Srcodesalittle/Ignition-panel-to-wake-on-lan/Circtuit diagram.PNG

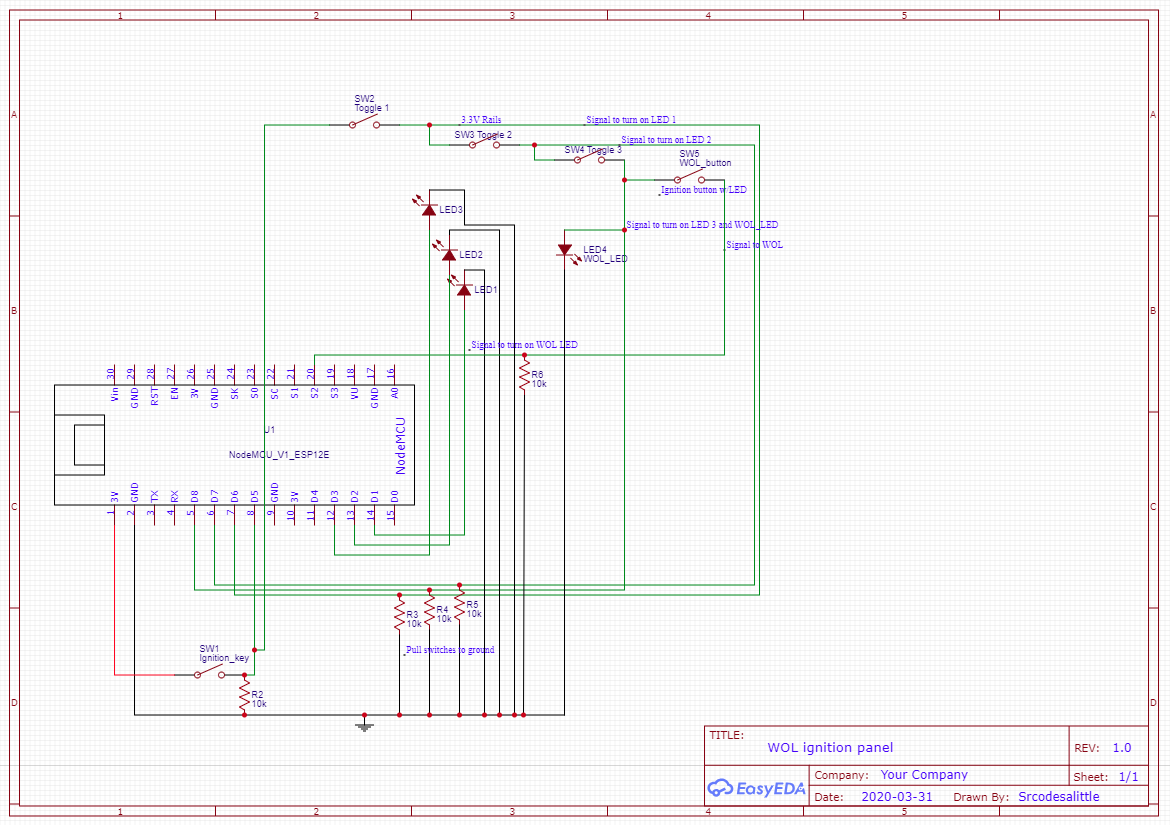
Circtuit diagram.PNG
