Srcodesalittle/Ignition-panel-to-wake-on-lan/Ign_1.jpg

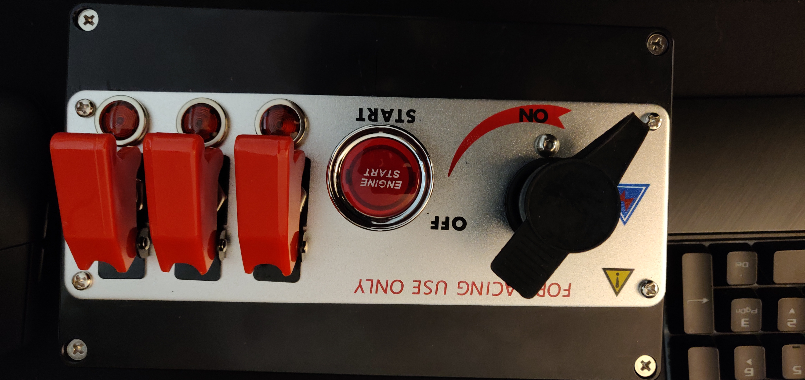
Ign_1.jpg
