Srcodesalittle/Ignition-panel-to-wake-on-lan/Ign_2.jpg

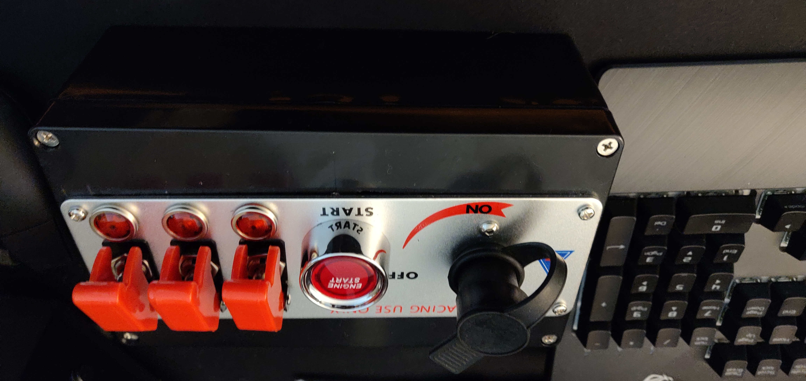
Ign_2.jpg
