Srcodesalittle/Ignition-panel-to-wake-on-lan/Ign_3.jpg

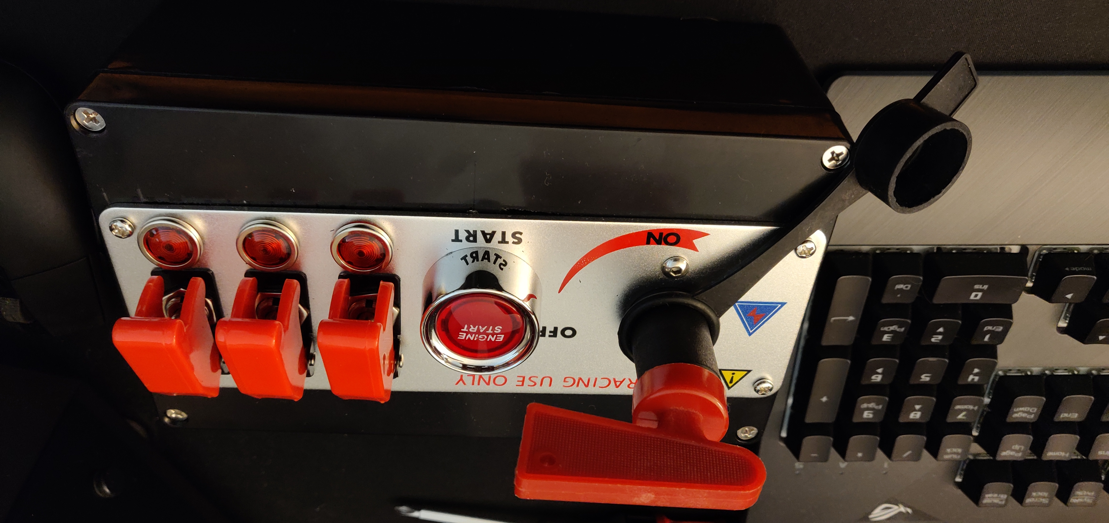
Ign_3.jpg
