Srcodesalittle/Ignition-panel-to-wake-on-lan/Final bill of materials.xlsx

Item | url | price (USD)
Ignition panel | https://www.aliexpress.com/item/32843875349.html?pid=808_0000_0231 | 14.64
nodemcu esp8266 | https://www.amazon.com/HiLetgo-Internet-Development-Wireless-Micropython/dp/B081CSJV2V/ | 13.99
resistors | https://www.amazon.com/AUSTOR-Resistors-Assortment-Resistor-Experiments/dp/B07BKRS4QZ | 10.59
jumper wires | https://www.amazon.com/Solderless-Flexible-Breadboard-Jumper-100pcs/dp/B005TZJ0AM | 7.29
breadboard ** | https://www.amazon.com/DEYUE-breadboard-Set-Prototype-Board/dp/B07LFD4LT6 | 8.99
soddering bread board** | https://www.amazon.com/Cylewet-Solderable-Half-Sized-Breadboard-Arduino/dp/B07DM3H7W2 | 12.99
ethernet cable ** | https://www.amazon.com/AmazonBasics-RJ45-Cat-6-Ethernet-Patch-Cable-5-Feet-1-5-Meters/dp/B00N2VILDM | 6.27
micro usb cable with switch | https://www.amazon.com/gp/product/B00JU24Z3W | 5.99
always on battery pack | https://www.amazon.com/Voltaic-Systems-Formerly-Battery-Samsung/dp/B07ZS3WYZY | 29
Project box | https://www.amazon.com/gp/product/B07D23BF7Y | 12.59
