Srcodesalittle/Ignition-panel-to-wake-on-lan/(commit log)

2020-05-18 errors in schematic
2020-05-18 Added bill of materials
    [Bill of materials.xlsx]
2020-05-18 Add files via upload
    updated bill of materials
    [Bill of materials.xlsx]
2020-05-18 Add files via upload
    updated bill of materials.
    [Bill of materials.xlsx]
2020-05-19 Update README.md
    adding note about current limiting resistors
2020-06-09 Updating schematic to correct WOL pin
    the WOL button was correctly mapped to D4 in the code, however the circuit diagram had it mapped to S2. This would not work. Solution is to connect WOL to D4.
    Correcting schematic soon.
2020-06-09 Fixed schematic
    Redid the circuit diagram to accurately reflect WOL button feeding into pin D4. Also took opportunity to re-do circuit diagram to be more readable and less chicken-scratch. Major updates, so revised schematic to 2.0.
2020-06-09 Added info about inserting mac address
